gostohov/Diplom_Anna_4/docs/Annotatsia_ivashenceva.docx

АННОТАЦИЯ

В работе представлены этапы разработки устройства «Интерактивная доска электронных компонентов». В работе представлено схемотехническое, конструкторское, технологическое проектирование устройства. Разработаны схема электрическая структурная, схема электрическая принципиальная, алгоритм работы ВПО микроконтроллера, чертежи печатных плат, сборочные чертежи модулей, сборочный чертёж устройства, схема сборки, эскиз переходов, структурная схема экспериментального стенда. Проведены проверочные конструкторские расчёты. Сконструирован экспериментальный макет устройства. Проведено экспериментальное исследование работоспособности макета устройства.

Ключевые слова: интерактивная доска электронных компонентов, схемотехническое проектирование, конструкторское проектирование, технологическое проектирование.

ABSTRACT

In operation development stages of the "Interactive Board of Electronic Components" device are provided. In operation circuitry, designer, technological design of the device is provided. The structural electric circuit, a basic electric circuit, an algorithm of operation of VPO of the microcontroller, drawings of printed circuit boards, assembly drawings of modules, the assembly drawing of the device, the assembly scheme, the sketch of transitions, the skeleton diagram of the experimental bench are developed. Test designer calculations are carried out. The experimental prototype of the device is constructed. The pilot study of operability of a prototype of the device is conducted.

Keywords: interactive board of electronic components, circuitry design, designer design, technological design.
