gostohov/Diplom_Anna_4/docs/Spisok_uslovnykh_oboznacheniy_ivashenceva.docx

СПИСОК УСЛОВНЫХ ОБОЗНАЧЕНИЙ, СОКРАЩЕНИЙ И ТЕРМИНОВ

ВПО – Внутреннее программное обеспечение

ПО – Программное обеспечение

ЭД – Эксплуатационная документация

РТЗ – Расширенное техническое задание

ОС – Операционная система
