gostohov/Diplom_Anna_4/docs/plakat_PE.xlsx

Перв. применен. | Обозна-чение |  |  | Наименование |  |  |  | Кол. |  | Примечание
 | D2 |  |  | Диод Шоттки, 1N5819-T, 40 В, 1 А |  |  |  | 1
 | С1, С2 |  |  | Кер.ЧИП конд. 10 мкФ X5R 10% 16В 0805 |  |  |  | 2
 | C3 |  |  | Конденсатор танталовый SMD 1 мкФ, 16 В, тип A, 20% |  |  |  | 1
Справ №
 | С4…С8 |  |  | Кер.ЧИП конд. 0.1 мкФ X7R 50В 10% 0807 |  |  |  | 4
 | R1 |  |  | Чип резистор SMD 0.125Вт 0805 470 Ом, 1% |  |  |  | 1
 | RN1…RN7 |  |  | ЧИП резисторная сборка SMD, CAY16-101J4 4х100 Ом |  |  |  | 7
 | X1 |  |  | Разъем micro USB type B |  |  |  | 1
 | X2 |  |  | Разъем вилка штыревая PLS-6 (DS1021-1x6), 2.54мм 1x6 |  |  |  | 1
Подпись и дата | X3 |  |  | Разъем вилка штыревая PLS-4 (DS-1021-1x4), 2.54мм 1x4 |  |  |  | 1
 | X4 |  |  | Разъем вилка штыревая PLD-40 (DS-1021- 2x20), 2.54мм 2х20 |  |  |  | 1
 | L1 |  |  | Индуктивность SMD SDR0604-101KL, 100 мкГн |  |  |  | 1
Инв. № дубл. | H |  |  | Светодиод в корпусе 1206 |  |  |  | 1
 | DD1 |  |  | Микроконтроллер STM32F100R6T6B в корпусе QFP-64 |  |  |  | 1
 | DA1 |  |  | Конвертер напряжения DC-DC LM2594 в корпусе SOIC |  |  |  | 1
Взам. инв. №
Подп. и дата
 |  |  |  |  |  |  | ???
Инв. № подл. | Изм | Лист | № докум |  | Подп | Дата
 | Разраб. |  | Ивашенцева |  |  |  | Плакат |  | Лит. |  | Лист | Листов
 | Пров. |  | Арабов |  |  |  |  |  |  |  | 1 | 1
 |  |  |  |  |  |  | Перечень элементов |  | МГТУ им. Баумана
 | Н.контр.
 | Утв.
 |  |  |  |  |  |  | Копировал |  | Формат А4
