gostohov/Diplom_Anna_4/EAGLE/Analog/Analog_4.dxf

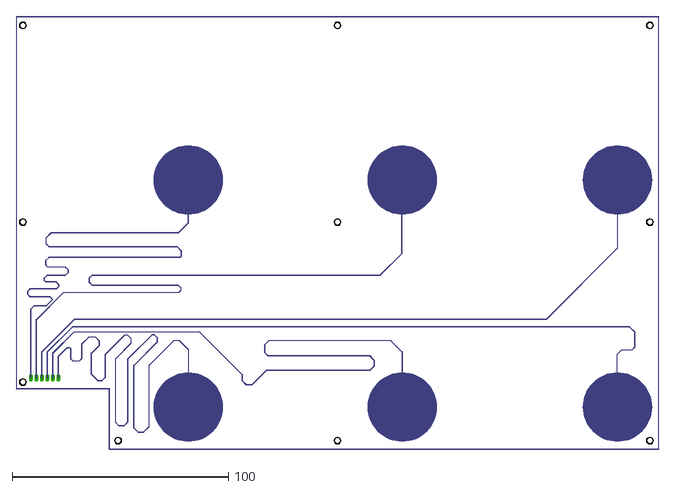
[picture p7: CAD file, 2017-05-29]
EAGLE/Analog/Analog_4.dxf
297.4 x 200.4
