gostohov/Diplom_Anna_4/EAGLE/Analog/Analog_3.dxf

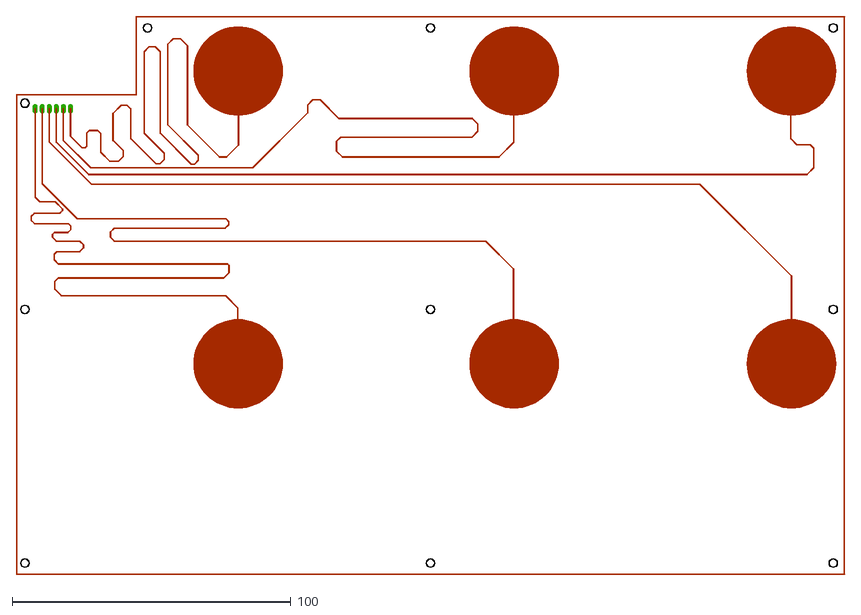
[picture p8: CAD file, 2017-05-29]
EAGLE/Analog/Analog_3.dxf
297.4 x 200.4
