gostohov/Diplom_Anna_4/EAGLE/Analog/Analog_2.dxf

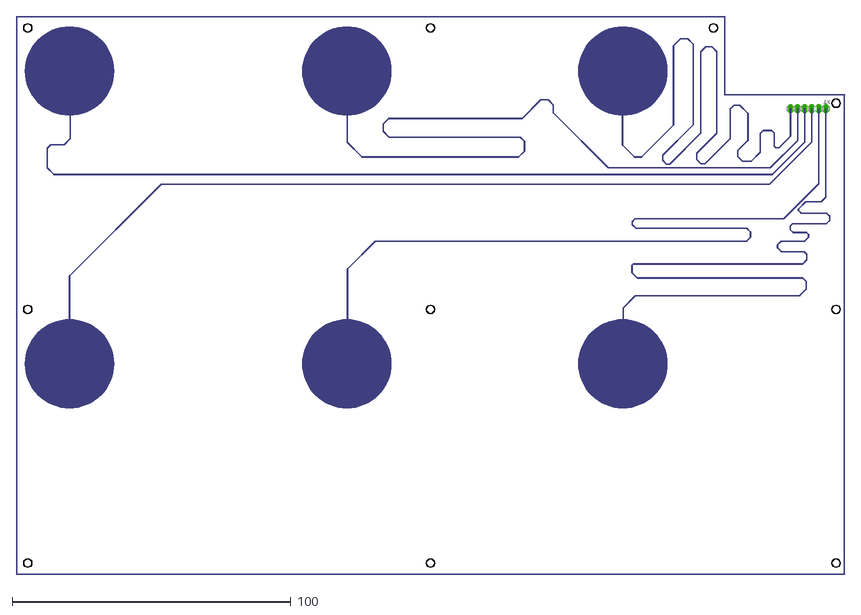
[picture p9: CAD file, 2017-05-29]
EAGLE/Analog/Analog_2.dxf
297.4 x 200.4
