gostohov/Diplom_Anna_4/EAGLE/Analog/Analog_1.dxf

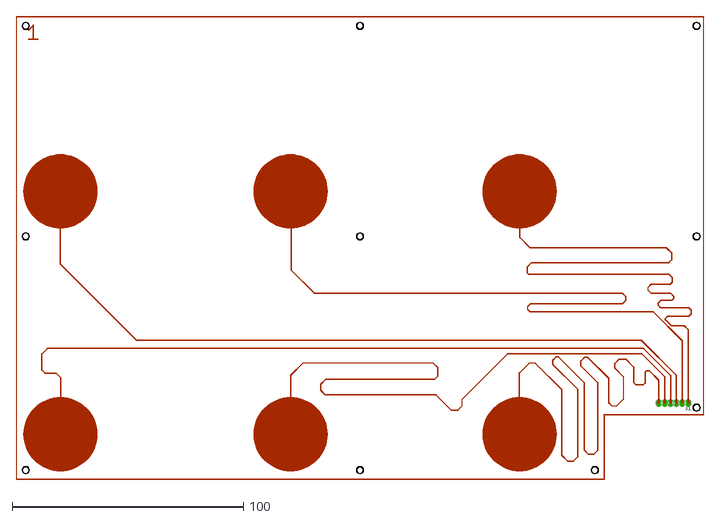
[picture p10: CAD file, 2017-05-29]
EAGLE/Analog/Analog_1.dxf
297.4 x 200.4
