gostohov/Diplom_Anna_4/drawings/Структурная схема.pdf

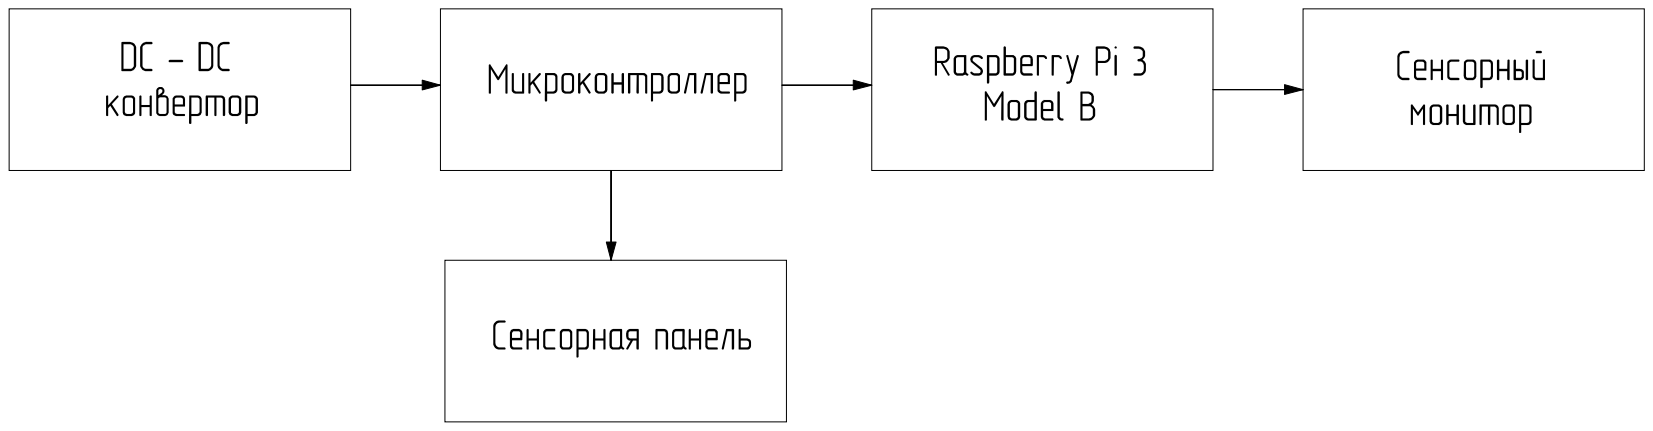
[picture p11: page 1]
