gostohov/Diplom_Anna_4/EAGLE/Plakat_ver2.0(up_to_date)/Plakat.brd

## EAGLE design EAGLE/Plakat_ver2.0(up_to_date)/Plakat.brd (2017-05-29)

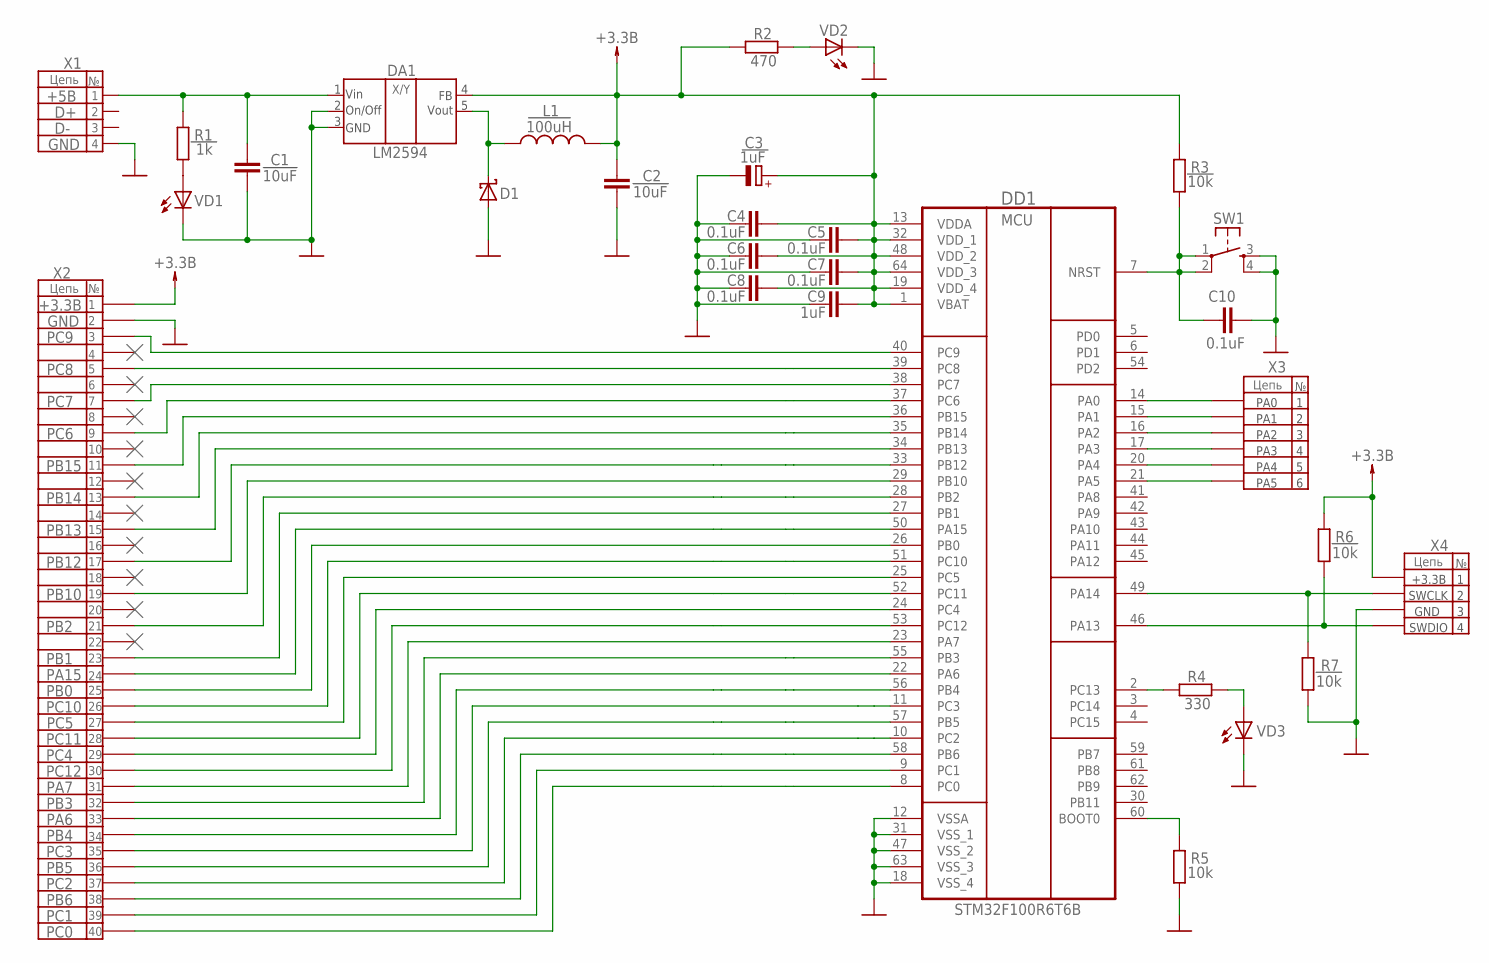
[picture p12: schematic Plakat.sch]

Parts:
C1, C2: 10uF; C0805
C3: 1uF; TYPE_A_TECAP
C4, C5, C6, C7, C8, C10: 0.1uF; C0805
C9: 1uF; C0805
D1: 1N5819-T; DO41-7.6
DA1: LM2594; LM2495
DD1: STM32F100R6T6B; QFP50P1200X1200X160-64N
L1: 100uH; 101KL
R1: 1k; R0805
R2: 470; R0805
R3, R5, R6, R7: 10k; R0805
R4: 330; R0805
SW1: DTSM-6
VD1, VD2, VD3: LED_E; LED_1206
X1: USB-MICROB
X2: PINHD-2X20; 2X20
X3: PINHD-1X6; 1X06
X4: PINHD-1X4; 1X04

Connections:
5V: C1.1, DA1.V(IN), R1.2, X1.VBUS
GND: C1.2, C2.2, C3.-, C4.1, C5.1, C6.1, C7.1, C8.1, C9.1, C10.2, D1.A, DA1.GND, DA1.ON/OFF, DD1.12 (VSSA), DD1.18 (VSS_4), DD1.31 (VSS_1), DD1.47 (VSS_2), DD1.63 (VSS_3), R5.1, R7.1, SW1.3, SW1.4, VD1.C, VD2.C, VD3.C, X1.GND, X1.MT1 (GND), X1.MT2 (GND), X2.2, X4.3
unnamed: DD1.60 (BOOT0), R5.2
unnamed: D1.C, DA1.OUT, L1.2
unnamed: DD1.14 (PA0), X3.1
unnamed: R1.1, VD1.A
unnamed: R4.2, VD3.A
unnamed: DD1.15 (PA1), X3.2
unnamed: DD1.2 (PC13), R4.1
unnamed: DD1.16 (PA2), X3.3
unnamed: DD1.17 (PA3), X3.4
unnamed: DD1.20 (PA4), X3.5
unnamed: DD1.21 (PA5), X3.6
unnamed: R2.2, VD2.A
unnamed: DD1.53 (PC12), X2.30
unnamed: C10.1, DD1.7 (NRST), R3.1, SW1.1, SW1.2
unnamed: DD1.40 (PC9), X2.3
unnamed: DD1.39 (PC8), X2.5
unnamed: DD1.38 (PC7), X2.7
unnamed: DD1.37 (PC6), X2.9
unnamed: DD1.36 (PB15), X2.11
unnamed: DD1.35 (PB14), X2.13
unnamed: DD1.34 (PB13), X2.15
unnamed: DD1.33 (PB12), X2.17
unnamed: DD1.29 (PB10), X2.19
unnamed: DD1.28 (PB2), X2.21
unnamed: DD1.27 (PB1), X2.23
unnamed: DD1.50 (PA15), X2.24
unnamed: DD1.26 (PB0), X2.25
unnamed: DD1.51 (PC10), X2.26
unnamed: DD1.25 (PC5), X2.27
unnamed: DD1.52 (PC11), X2.28
unnamed: DD1.24 (PC4), X2.29
unnamed: DD1.23 (PA7), X2.31
unnamed: DD1.55 (PB3), X2.32
unnamed: DD1.22 (PA6), X2.33
unnamed: DD1.56 (PB4), X2.34
unnamed: DD1.11 (PC3), X2.35
unnamed: DD1.57 (PB5), X2.36
unnamed: DD1.10 (PC2), X2.37
unnamed: DD1.58 (PB6), X2.38
unnamed: DD1.9 (PC1), X2.39
unnamed: DD1.8 (PC0), X2.40
SWCLK: DD1.49 (PA14), R7.2, X4.2
SWDIO: DD1.46 (PA13), R6.1, X4.4
VCC: C2.1, C3.+, C4.2, C5.2, C6.2, C7.2, C8.2, C9.2, DA1.FB, DD1.1 (VBAT), DD1.13 (VDDA), DD1.19 (VDD_4), DD1.32 (VDD_1), DD1.48 (VDD_2), DD1.64 (VDD_3), L1.1, R2.1, R3.2, R6.2, X2.1, X4.1

Notes on the sheet:
Цепь
+5В
GND
Vin
On/Off
Vout
+3.3В
SWDIO
SWCLK
PA0
PA1
PA2
PA3
PA4
PA5
MCU
PC9
PC8
PC7
PC6
PB15
PB14
PB13
PB12
PB10
PB2
PB1
PA15
PB0
PC10
PC5
PC11
PC4
PC12
PA7
PB3
PA6
PB4
PC3
PB5
PC2
PB6
PC1
PC0
STM32F100R6T6B

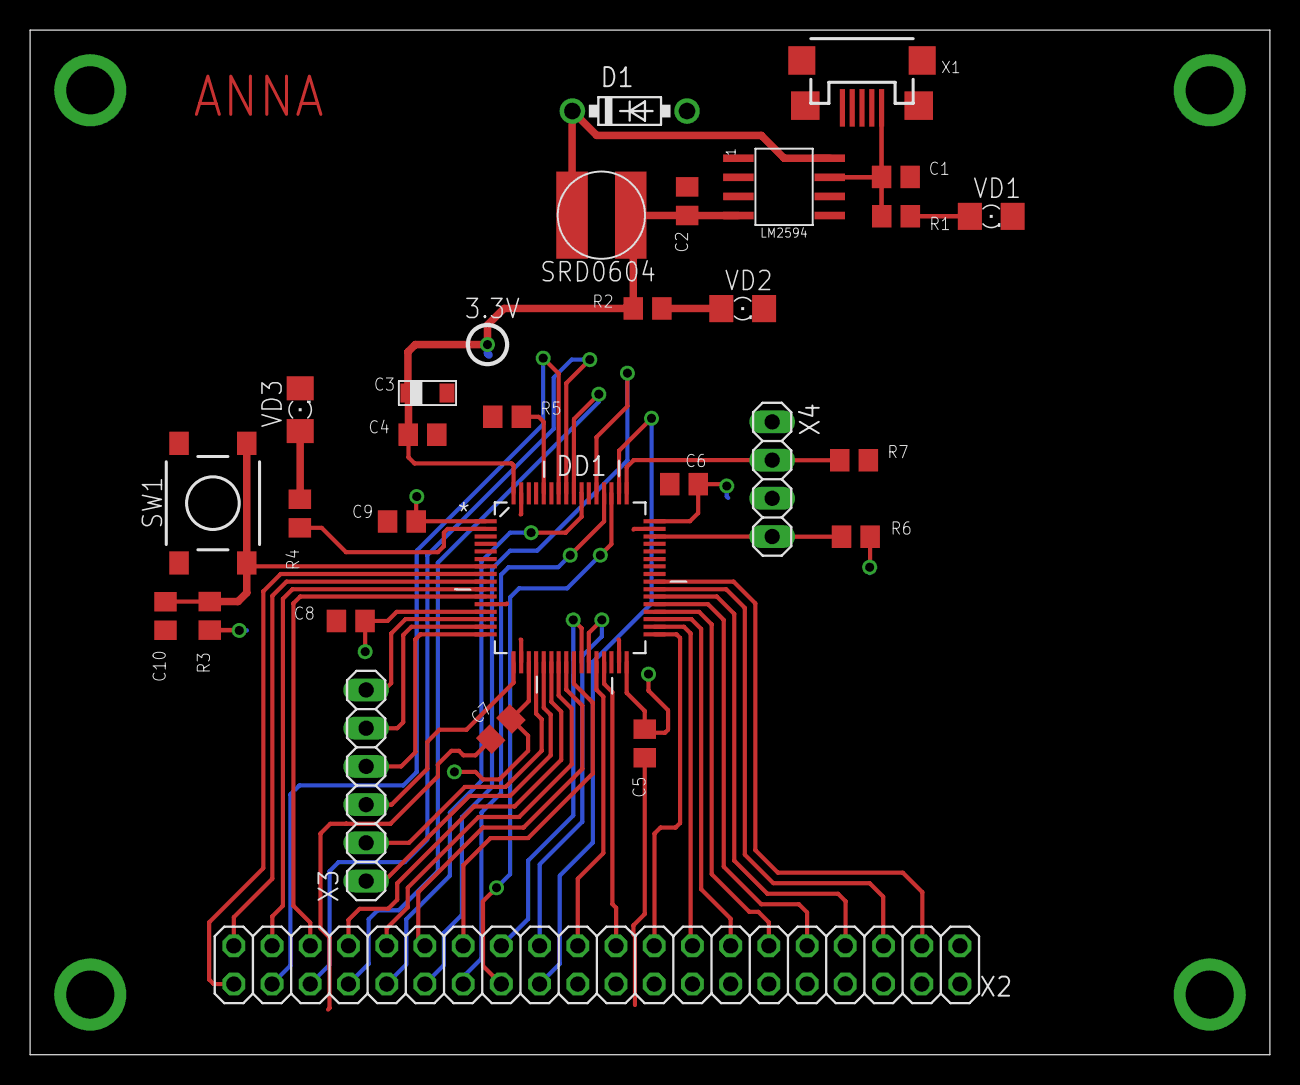
[picture p13: board EAGLE/Plakat_ver2.0(up_to_date)/Plakat.brd from above]

Board: 2 copper layers, 82.4 x 68.1 mm, 29 parts (0 on the bottom side), 46 nets.
