gostohov/Diplom_Anna_4/EAGLE/Plakay_ver1.0/Plakat.brd

## EAGLE design EAGLE/Plakay_ver1.0/Plakat.brd (2017-04-28)

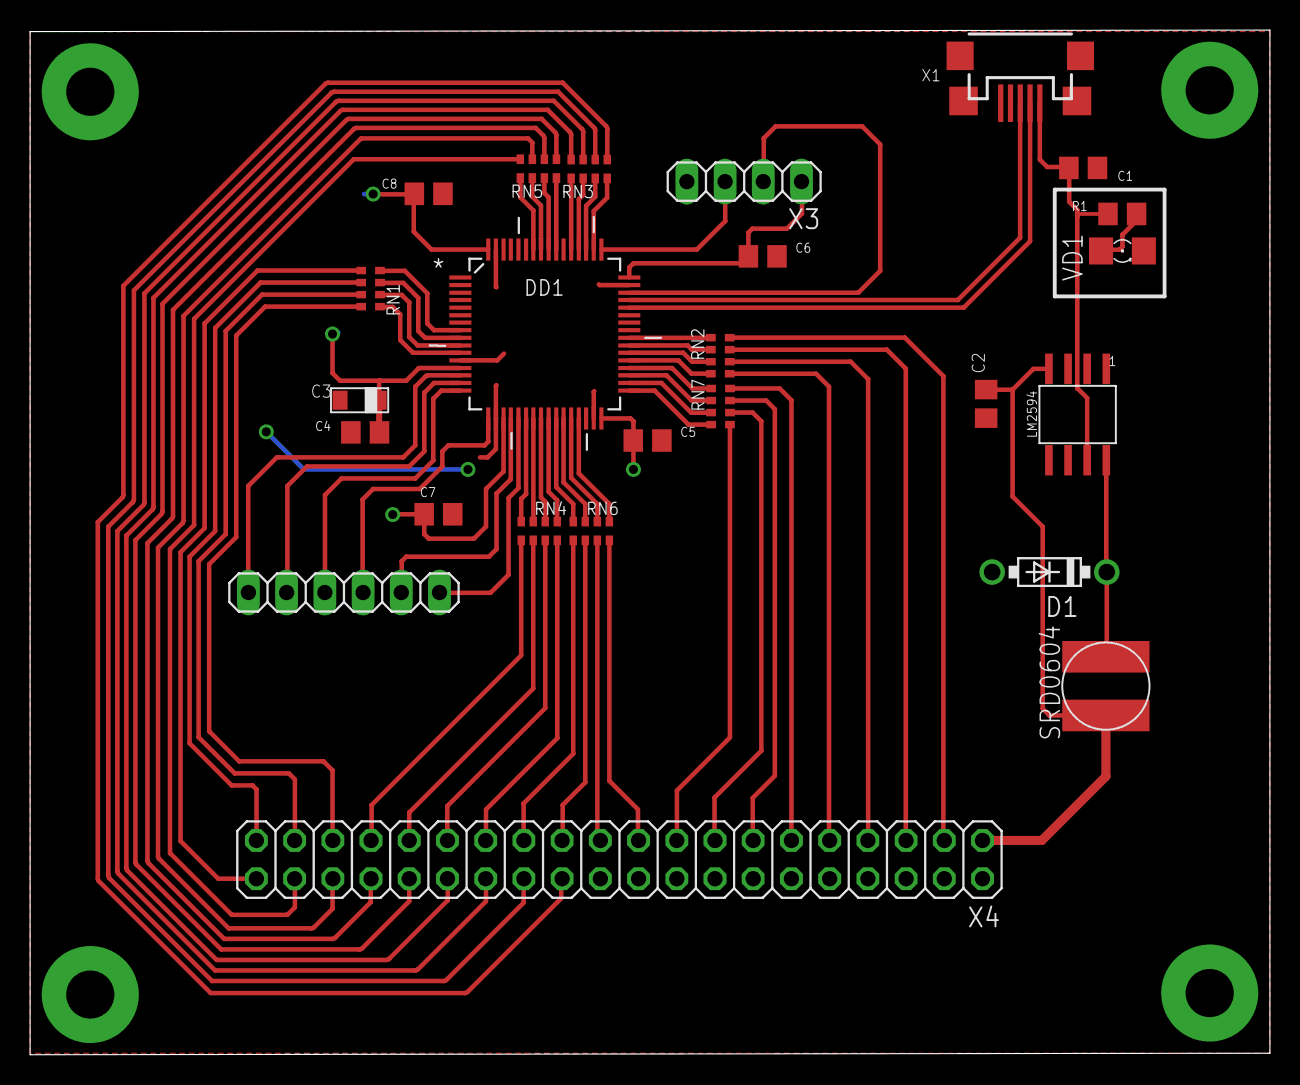
[picture p14: board EAGLE/Plakay_ver1.0/Plakat.brd from above]

Board: 2 copper layers, 82.4 x 68.1 mm, 25 parts (0 on the bottom side), 71 nets.

Parts:
C1, C2: 10uF; C0805
C3: 1uF; TYPE_A_TECAP
C4, C5, C6, C7, C8: 100nF; C0805
D1: 1N5819-T; DO41-7.6
DA1: LM2594; LM2495
DD1: STM32F100R6T6B; QFP50P1200X1200X160-64N
L1: 100uH; 101KL
R1: 470; R0805
RN1, RN2, RN3, RN4, RN5, RN6, RN7: 100; 0603-ARC
VD1: LED_1206
X1: USB-MICROB
X2: 1X06
X3: 1X04
X4: 2X20

Connections:
DM: DD1.44, X1.D-
DP: DD1.45, X1.D+
GND: C1.2, C2.2, C3.-, C4.2, C5.2, C6.2, C7.2, C8.2, D1.A, DA1.GND, DA1.ON/OFF, DD1.12, DD1.18, DD1.31, DD1.47, DD1.63, VD1.C, X1.GND, X1.MT1, X1.MT2, X3.4, X4.2
unnamed: C1.1, DA1.V(IN), R1.2, X1.VBUS
unnamed: D1.C, DA1.OUT, L1.2
unnamed: DD1.14, X2.1
unnamed: R1.1, VD1.A
unnamed: DD1.8, RN1.4
unnamed: DD1.15, X2.2
unnamed: DD1.9, RN1.3
unnamed: DD1.16, X2.3
unnamed: DD1.17, X2.4
unnamed: DD1.20, X2.5
unnamed: DD1.21, X2.6
unnamed: DD1.10, RN1.2
unnamed: DD1.11, RN1.1
unnamed: DD1.24, RN4.2
unnamed: DD1.25, RN4.1
unnamed: DD1.37, RN2.4
unnamed: DD1.38, RN2.3
unnamed: DD1.39, RN2.2
unnamed: DD1.40, RN2.1
unnamed: DD1.51, RN3.3
unnamed: DD1.50, RN3.4
unnamed: DD1.22, RN4.4
unnamed: DD1.23, RN4.3
unnamed: DD1.26, RN6.4
unnamed: DD1.27, RN6.3
unnamed: DD1.55, RN5.4
unnamed: DD1.56, RN5.3
unnamed: DD1.57, RN5.2
unnamed: DD1.58, RN5.1
unnamed: DD1.28, RN6.2
unnamed: DD1.29, RN6.1
unnamed: DD1.33, RN7.4
unnamed: DD1.34, RN7.3
unnamed: DD1.35, RN7.2
unnamed: DD1.36, RN7.1
unnamed: RN2.8, X4.3
unnamed: RN2.7, X4.5
unnamed: RN2.6, X4.7
unnamed: RN2.5, X4.9
unnamed: RN7.8, X4.11
unnamed: RN7.7, X4.13
unnamed: RN7.6, X4.15
unnamed: RN7.5, X4.17
unnamed: RN6.8, X4.19
unnamed: RN6.7, X4.21
unnamed: RN6.6, X4.23
unnamed: RN6.5, X4.25
unnamed: RN4.8, X4.27
unnamed: RN4.7, X4.29
unnamed: RN4.6, X4.31
unnamed: RN4.5, X4.33
unnamed: RN1.8, X4.35
unnamed: RN1.7, X4.37
unnamed: RN1.6, X4.39
unnamed: RN1.5, X4.40
unnamed: RN5.8, X4.38
unnamed: RN5.7, X4.36
unnamed: RN5.6, X4.34
unnamed: RN5.5, X4.32
unnamed: RN3.8, X4.30
unnamed: RN3.7, X4.28
unnamed: RN3.6, X4.26
unnamed: DD1.52, RN3.2
unnamed: DD1.53, RN3.1
unnamed: RN3.5, X4.24
SWCLK: DD1.49, X3.3
SWDIO: DD1.46, X3.2
VCC: C2.1, C3.+, C4.1, C5.1, C6.1, C7.1, C8.1, DA1.FB, DD1.13, DD1.19, DD1.32, DD1.48, DD1.64, L1.1, X3.1, X4.1
