gostohov/Diplom_Anna_4/(commit log)

2017-03-23 Добавила код и разводку, кнопок пока нет
2017-04-03 Создал папку docs
    [plakat_PE.xlsx]
2017-04-12 Glava 1. Version 1.0
    пока сделано только от 1.1 до 1.2.2
2017-04-12 Добавил чертежи
    Принципиальная схема - для сдачи Соловьеву. Она запушная, её надо
    переделывать, но для того, чтобы показать сойдет.
    Структурная схема - тоже для показа. Надо поправить основную надпись.
2017-04-19 Add files via upload
    Написала полностью первую главу, готовый вариант.
2017-04-19 Add files via upload
    добавила содержание, интересно правильно ли шаблон выбран. Пока только первой главы
2017-04-28 Edited plakat_залипуха
    [Plakat_залипуха.brd, Plakat_залипуха.dxf, Plakat_залипуха.sch]
2017-04-28 Plakat.sch was redrawed by the right way
    [Plakat.brd, Plakat.sch, Plakat_залипуха.brd, Plakat_залипуха.dxf, Plakat_залипуха.sch]
2017-04-28 Modified Plakat.brd
    [Plakat.brd]
2017-04-29 Created drawaings. Working with ИУ4 2205.05.01.00
2017-04-29 End: Сборочный чертеж и спецификацию
2017-04-29 Ended Печатная плата
2017-04-30 Modified Печатная плата.cdw
2017-05-15 Modified СБ, Э3, ПП
    [Plakat.sch]
2017-05-18 Created analog pcb
    [A4_pattern.brd, Analog_1.brd, Analog_2.brd, Analog_3.brd, Analog_4.brd]
2017-05-21 Created Plakat_ver2.0
    This version of PCB is up-to-date. Change list:
    1. Added RESET button
    2. Deleted resistor-arrays
    3. Modified SWD communication
    4. VBAT pull-up to VCC
    5. BOOT0 pulled-down throught resistor
    6. Added VD2 and VD3
    7. Fixed schematic - now capacitors doted to VCC
    [A4_pattern.brd, Analog_1.brd, Analog_2.brd, Analog_3.brd, Analog_4.brd, Plakat.brd, Plakat.sch]
2017-05-22 Created Цифровой модуль СП, СБ, ПП
    [Plakat.sch]
2017-05-29 Я уже ничего не помню
    [Analog_1.brd, Analog_1.dxf, Analog_2.brd, Analog_2.dxf, Analog_3.brd, Analog_3.dxf, Analog_4.dxf, Plakat.brd]
2017-06-05 Кто инжинир? Я инжинир
